hsgw/plaid/doc/case.md

# Soldering switches

Unplug USB cable and solder mx switches.   
You can choose grid or mit layout.
If finish soldering, you should test typing.

# Install bottom PCB and acrylic cover

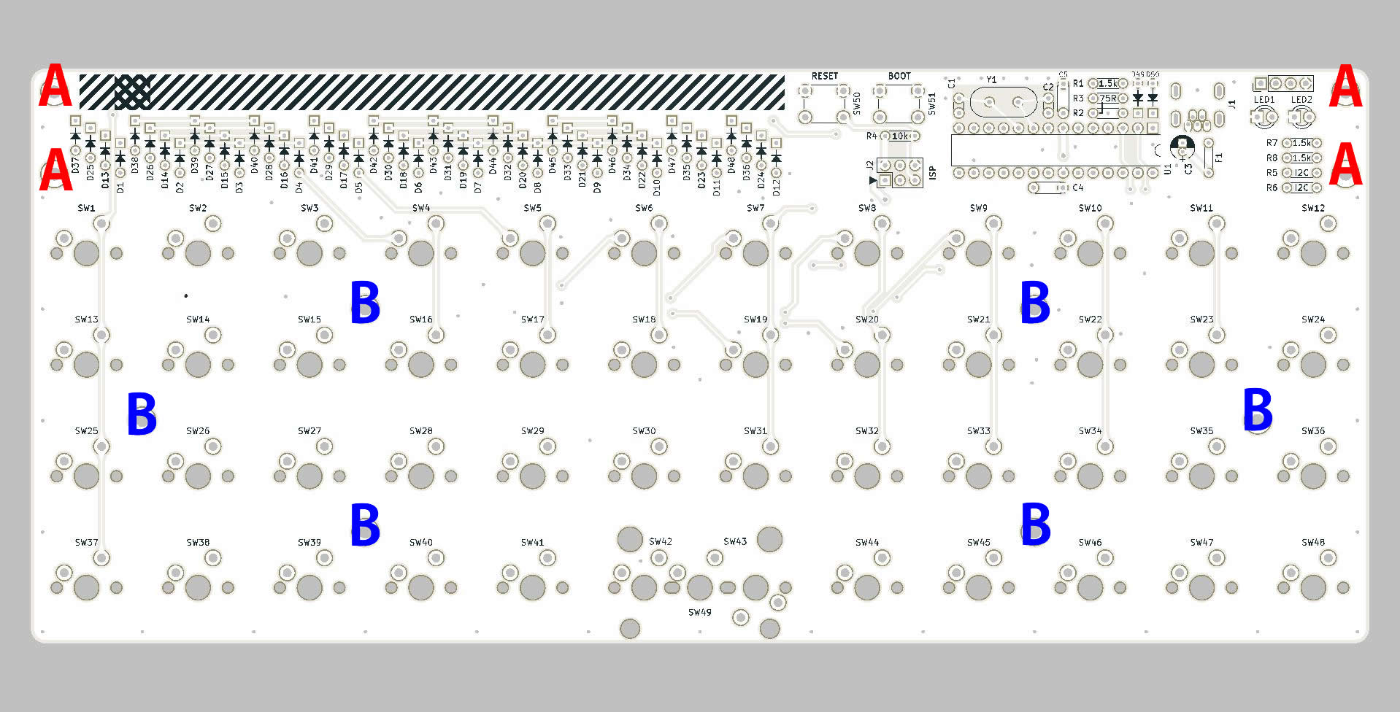
[picture p3: doc/img/assembly/plaid_pcb_top_screw.jpg]
hole


## A
use screws, nuts, spacers and acrylic cover.
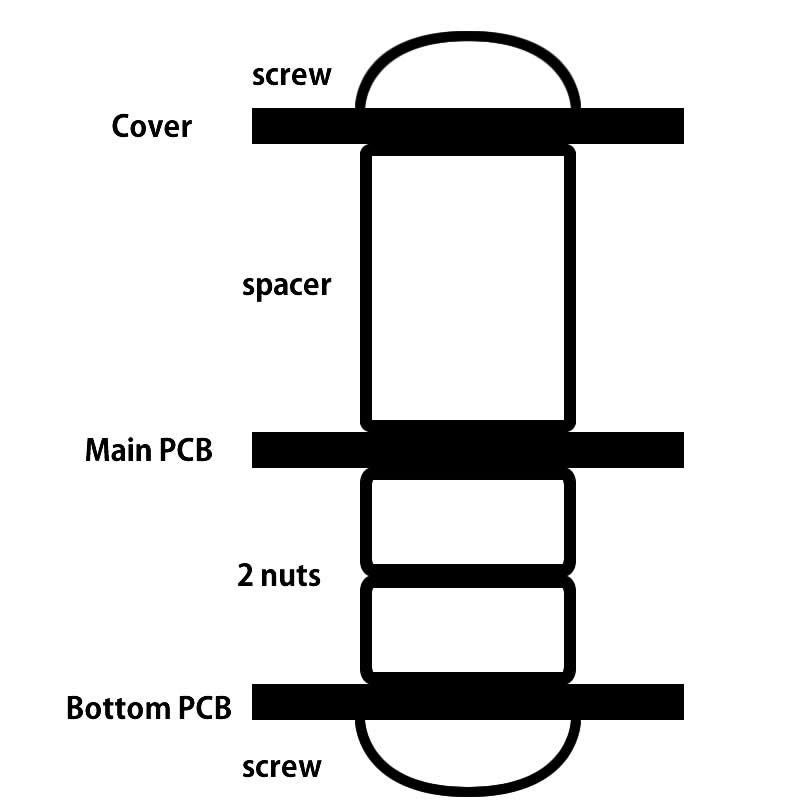
[picture p4: doc/img/assembly/screw_a.jpg]
screwA


## B
use screws and nuts.
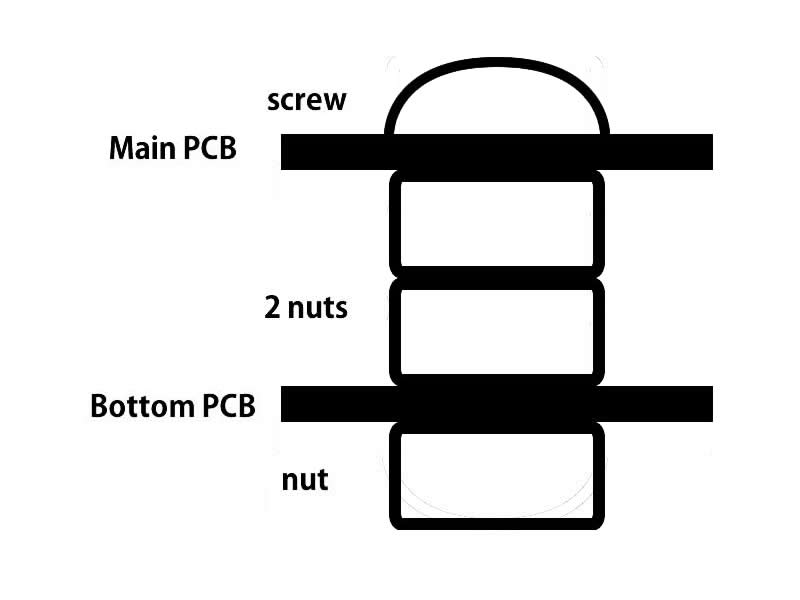
[picture p5: doc/img/assembly/screw_b.jpg]
screwB


## Install keycaps

## COMPLETE!
plaid
