hsgw/plaid/doc/jp/complete.md

# スイッチのはんだづけ

USBケーブルを抜いてスイッチをはんだづけします。
gridレイアウトとmitレイアウトが選べます。
はんだづけが終わったらPCに繋いで正しくタイピングが出来るか確認しましょう。

# ボトムPCBとアクリルカバーの取り付け

hole

## A
ねじ、ナット、スペーサー、アクリルカバーを取り付けます。
screwA

## B
ねじとナットを取り付けます
screwB

## キーキャップを取り付けます

## 完成!
plaid
