hsgw/plaid/doc/img/plaid_bottom_bottom.jpg

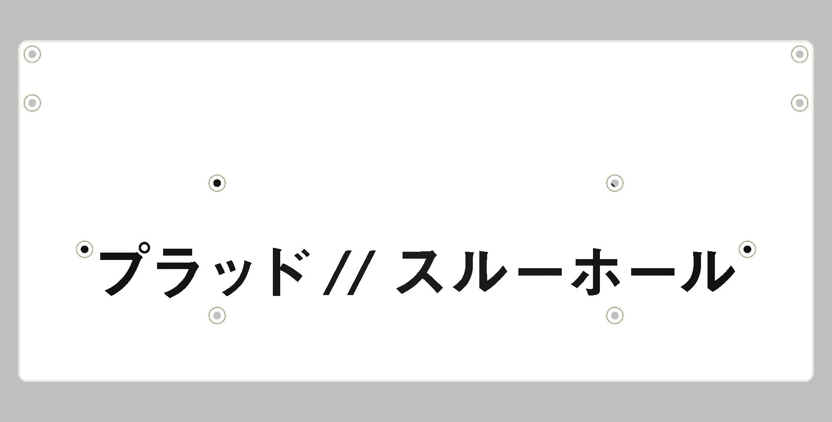
doc/img/plaid_bottom_bottom.jpg
