hsgw/plaid/doc/img/plaid_bottom_top.jpg

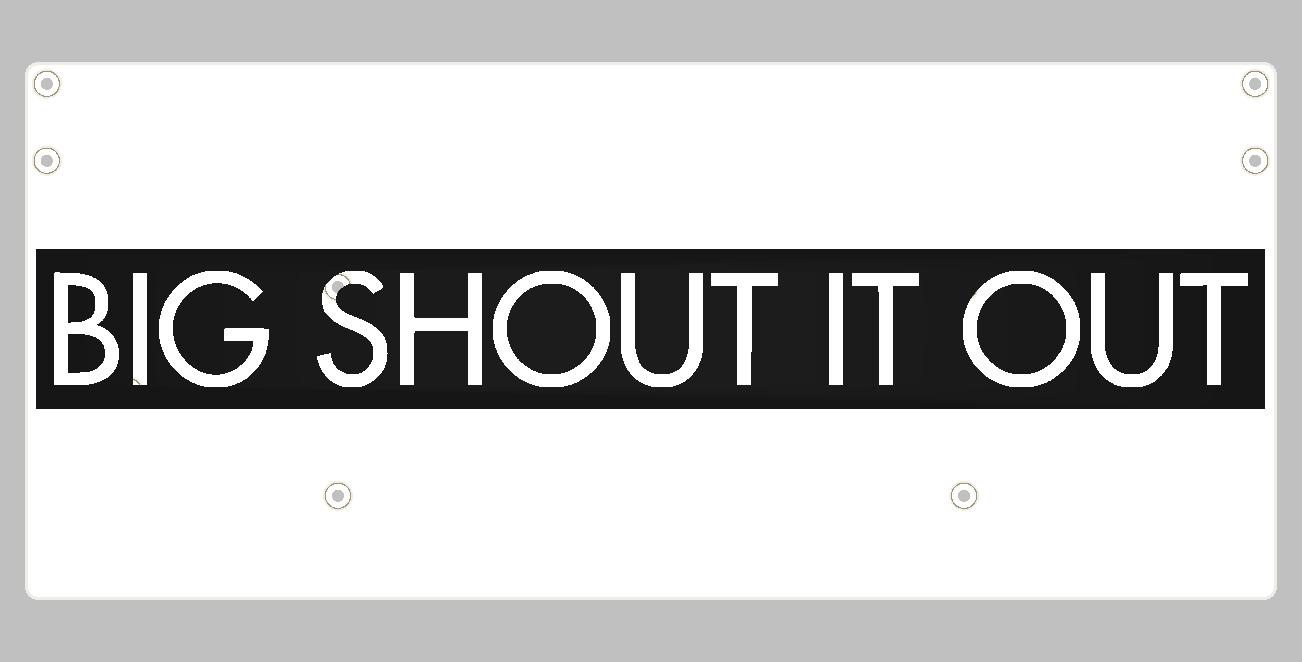
doc/img/plaid_bottom_top.jpg
