hsgw/plaid/doc/img/plaid_pcb_bottom.jpg

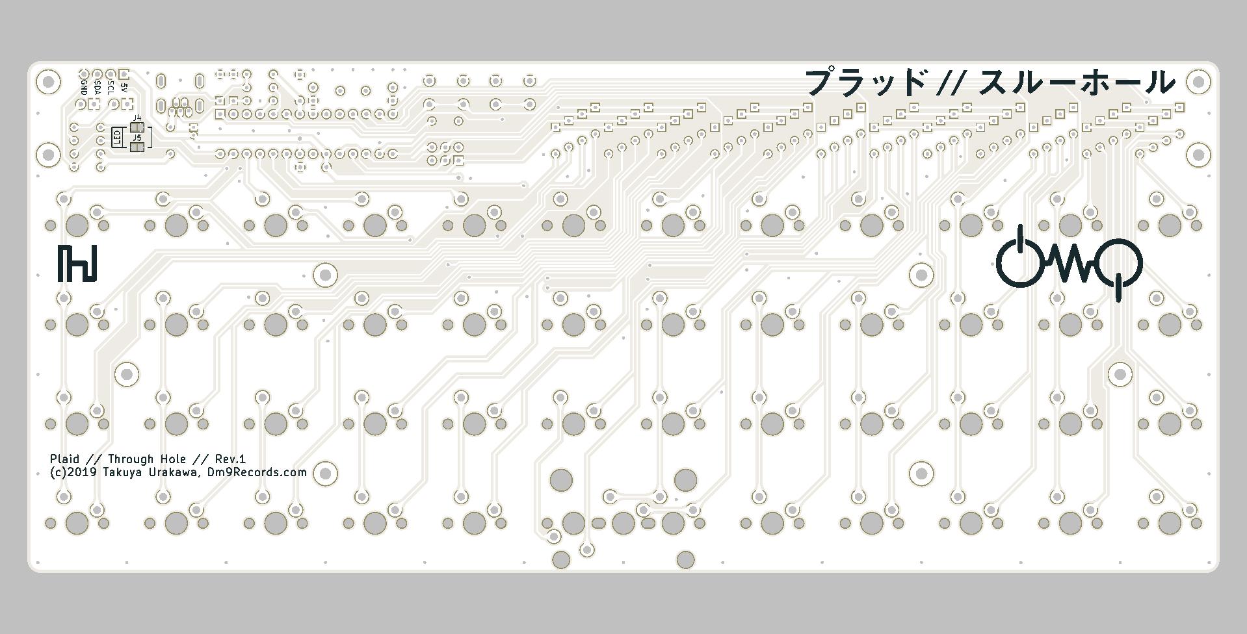
doc/img/plaid_pcb_bottom.jpg
