hsgw/plaid/doc/img/plaid_render_grid.png

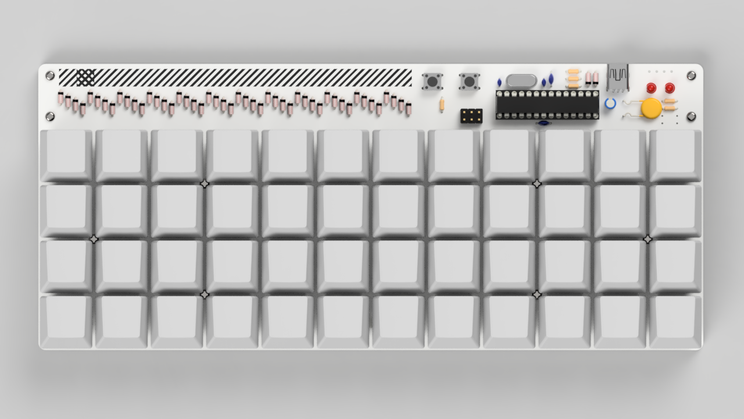
doc/img/plaid_render_grid.png
