hsgw/plaid/doc/en/BOM.md

# BOM 
## Included in Plaid kit
| | Ref | Qty | Value | Description |
|---|---|-----|---|---|
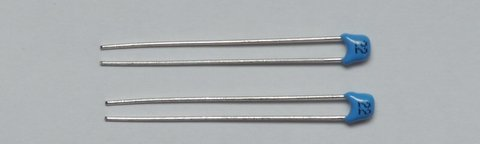
[picture p10: doc/img/parts/P1020154.JPG]
22pF
|  | C1, C2 | 2 | 22p | Multi layer ceramic capacitor (2.5mm pitch) |
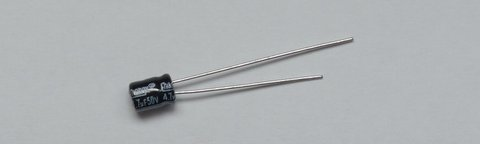
[picture p11: doc/img/parts/P1020157.JPG]
4.7uF
|  | C3 | 1 | 4.7u | Electrolytic capacitor (1.5mm pitch) |
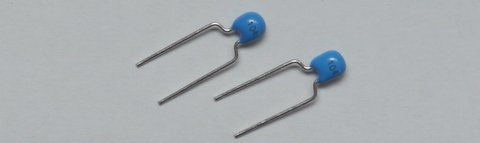
[picture p12: doc/img/parts/P1020155.JPG]
100nF
|  | C4, C5 | 2 | 100n | Multi layer ceramic capacitor (5mm pitch) |
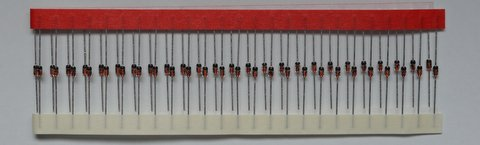
[picture p13: doc/img/parts/P1020138.JPG]
1N4148
|  | D1-48 | 48  | 1N4148 | General-purpose diode (DO-35) |
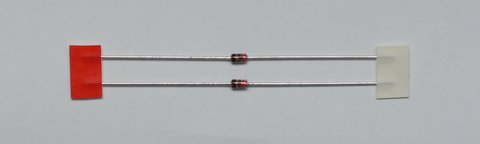
[picture p14: doc/img/parts/P1020151.JPG]
3.6V
|  | D49, D50 | 2 | 3.6V | 3.6V zener diode (DO-35) |
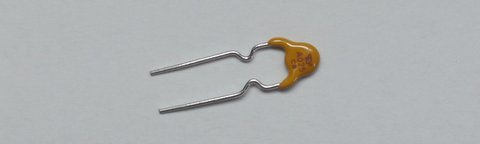
[picture p15: doc/img/parts/P1020156.JPG]
fuse
|  | F1 | 1 | 100mA | Resettable fuse (5mm pitch) |
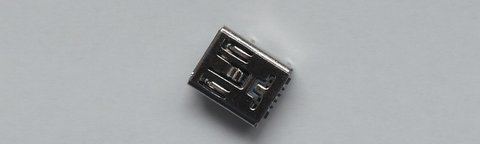
[picture p16: doc/img/parts/P1020147.JPG]
USB
|  | J1 | 1 | USB MINI-B | USB miniB connector |
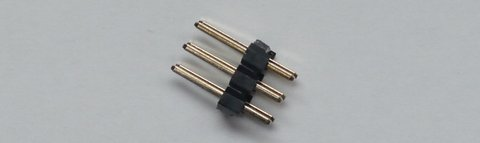
[picture p17: doc/img/parts/P1020158.JPG]
2x3
|  | J2 | 1 | 02x03 | AVR ISP pin header |
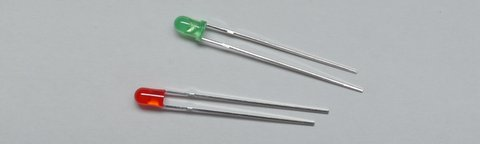
[picture p18: doc/img/parts/P1020159.JPG]
LED
|  | LED1,2 | 2 | RED, GREEN | 3mm LED |
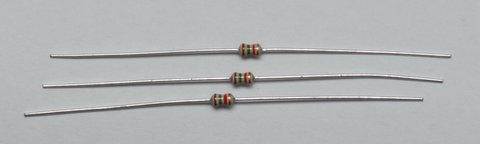
[picture p19: doc/img/parts/P1020161.JPG]
1.5k
|  | R1, R7, R8  | 3 | 1.5k | 1/6W resistor |
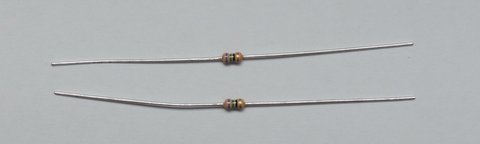
[picture p20: doc/img/parts/P1020160.JPG]
75R
|  | R2, R3 | 2 | 75R | 1/6W resistor |
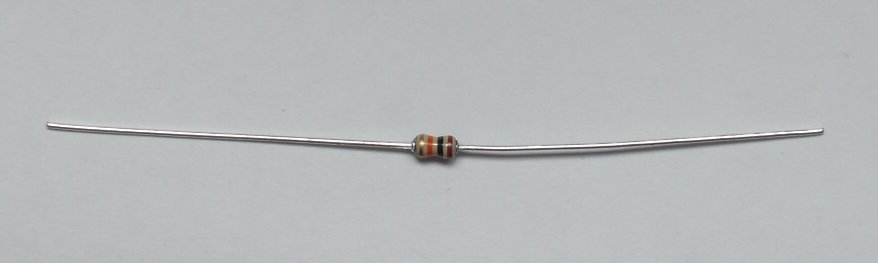
[picture p21: doc/img/parts/P1020162.JPG]
10k
|  | R4 | 1 | 10k | 1/6W resistor |
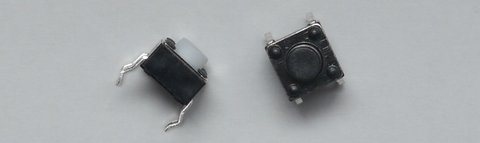
[picture p22: doc/img/parts/P1020153.JPG]
|  | SW50, SW51 | 2 | RESET, BOOT | 6mm tactile switch |
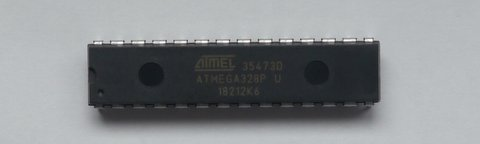
[picture p23: doc/img/parts/P1020149.JPG]
|  | U1 | 1 | ATMEGA328P | |
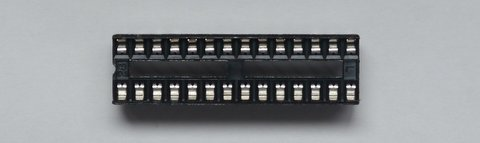
[picture p24: doc/img/parts/P1020148.JPG]
|  | IC Socket | 1 | 28pin | 28pin IC Socket |
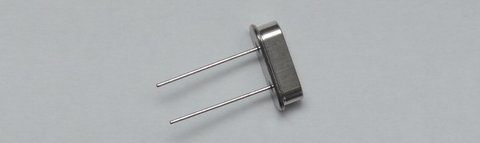
[picture p25: doc/img/parts/P1020150.JPG]
|  | Y1 | 1 | 16MHz | |
| | Screw | 14  | M2 8mm | |
| | Nut | 26  | M2 | |
| | Spacer | 4 | M2 10mm | |
| | Rubber Feet | 4 | | |
| | PCB | 1 | MAIN PCB | |
| | PCB | 1 | BOTTOM PCB | |

## Not included
- Cherry MX compatible switches * 48   
**PCB mount (5pin) type**

- USB miniB cable
