hsgw/plaid/(list of files, cad)

Other CAD files:
pcb/cover.dwg
