hsgw/plaid/doc/jp/soldering.md

# はんだづけ

## 組立を始める前に
- 部品が揃っているか[BOM](./BOM.md)を見て確認する
- もしはんだづけに不慣れなら以下のサイトで勉強する
  - [Helixキーボードキットの制作に必要な工具メモ](https://gist.github.com/mtei/6957107a676ddfa85bde0ae41f8fa849)内の[リンク集 - はんだづけ編](https://gist.github.com/mtei/6957107a676ddfa85bde0ae41f8fa849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)
  - https://learn.adafruit.com/adafruit-guide-excellent-soldering/tools

## はんだづけ
### ツェナーダイオード (D49,50)
D49とD50をはんだづけします。   
ダイオードは`極性`があります。向きに注意して下さい。   
ダイオードの黒い帯がある方がカソードです。(PCBの四角いパッド側)   

zener diode

### 抵抗 (R1,2,3,4,7,8)
抵抗をはんだづけします。   
R5とR6はI2C用なので何も実装しません。

| Ref | 値 | カラーコード |
|---|---|---|
| R1,7,8 | 1.5k  | 茶/緑/赤/金 |
| R2,3 | 75 | 紫/緑/黒/金 |
| R4 | 10k | 茶/黒/オレンジ/金 |
| R5,6 | I2C | 実装しない |

resistor

### ダイオード 1N4148 (D1-48)
ダイオードは`極性`があります。向きに注意して下さい。   
ダイオードの黒い帯がある方がカソードです。(PCBの四角いパッド側) 

1N4148

### クリスタル
crystal

### 積層セラミックコンデンサ (C1,2,4,5)
2種類のコンデンサがあります。

| Ref  | 値 | リードの間隔 |
|---|---|---|
| C1,2 | 22pF  | 2.5mm |
| C4,5 | 0.1uF | 5mm |

MLCC

### USB コネクタ
ピンの間隔が狭いのでブリッジに注意して下さい。   
はんだづけしたあとによく確認すること。

USB

### LED
LEDは`極性`があります。向きに注意して下さい。   
短い足の方がカソードです。(PCBの四角いパッドの方)

LED

LEDを使用するなら、PCB裏面のJ4とJ5をブリッジして下さい。

LED jumper

### ICソケット
ICソケットは`極性`があります。向きに注意して下さい。   
ICソケットの端の切り欠けとPCB上のシルクをあわせます。

ic socket

### 電解コンデンサ(C3)とリセッタブルフューズ(F1)
電解コンデンサは`極性`があります。向きに注意して下さい。   
短い足の方がカソードです。(PCBの四角いパッドの方)

リセッタブルフューズをはんだづけしたあと、画像のように折り曲げておきます。

Electrolytic capacitor and resettable fuse

### タクタイルスイッチ(SW50,51)とピンヘッダ

SW and pin header

### ATMEGA328P
ATMEGA328PをICソケットに差し込みます。

ATMEGA328Pは`極性`があります。向きに注意して下さい。   
ICソケットの切り欠けとATMEGA328Pの切り欠けをあわせます。   
画像も参考にして下さい。

ATMEGA328p

## USBケーブルを接続する前のチェックリスト
- VCC(5V)とGNDがショートしていないか、USBコネクタのピンがショートしていないか
- 極性のある部品の向き(ATMEGA328P、ダイオード、リセッタブルヒューズ、電解コンデンサ)
- 抵抗の値と場所

## NEXT
[USBケーブルを接続してブートローダをテストする](./bootloader.md)
