hsgw/plaid/doc/img/assembly/13.JPG

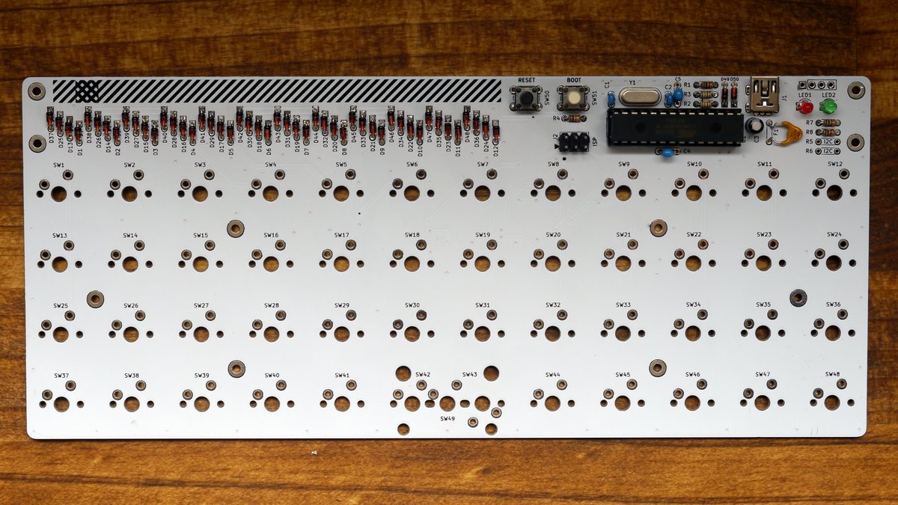
doc/img/assembly/13.JPG
