hsgw/plaid/(threads)

Thread 1 (2018-12-21):

PCB Rev.Alpha issues

hsgw, 2018-12-21:
- missing 2U stabilizer cutout
- R3 and R4 is 75 ohm (even 68 ohm, it should work)
- Polarized pads in C3 are other way around. but silk is correct.

hsgw, 2019-04-08:
Release Rev.1

Closed 2019-04-08.

Thread 2 (2019-02-14):

Resistor slots are too short for 10k and 1.5k resistors

themoonisacheese, 2019-02-14:
the slots for R1,4,6,7 are shorter than the standard size for these resistors.
I was able to mount them anyway by bending the leg under each resistor to match the hole, but please consider allocating more space, especially considering all of these resistors have (visually, I don't know if there is a trace there) enough space next to them.

hsgw, 2019-02-17:
All resistors are 1/8W and fit without issues.

Closed 2019-02-17.

Thread 5 (2019-04-10):

BOM Parts

mrceephax, 2019-04-10:
Hi,

I would be so helpful to have the parts organised either through octopart.com or with some serial numbers, I'm able to find them but its a bit difficult when the "Value" term is used as a generic  attribute.

Thanks

imbarelyonline, 2019-04-16:
I used Octopart to keep track of components as I found them on Mouser. You can use (and correct!) my list if you'd like. [Public Plaid Electronics](https://octopart.com/bom-tool/t5azwMqr/G5hAETgBxOPJR9aY)

miguelangelramirez, 2019-04-24:
Don't know if you guys have stumbled into this link to octopart with the list: https://octopart.com/bom-tool/t5azwMqr/G5hAETgBxOPJR9aY

lscott3, 2020-08-13:
So it looks like the two links shared here are the same.

Can someone verify that all of the parts listed work? If so, I think I'll open a PR to add the more detailed and exact name in the BOM list.

Thread 6 (2019-04-15):

make plaid:default:program fails with avr-gcc 8

brianmutualaid, 2019-04-15:
I just ran into this issue on macOS and thought I would open an issue just in case others have it too. When using the default avr-gcc (8.2.0) that's installed with homebrew, I get the following output when running `make plaid:default:program`:

```$ make plaid:default:program
QMK Firmware 0.6.308
WARNING:
 Some git sub-modules are out of date or modified, please consider running:
 make git-submodule
 You can ignore this warning if you are not compiling any ChibiOS keyboards,
 or if you have modified the ChibiOS libraries yourself.

Making plaid with keymap default and target program

avr-gcc (GCC) 8.2.0
Copyright (C) 2018 Free Software Foundation, Inc.
This is free software; see the source for copying conditions.  There is NO
warranty; not even for MERCHANTABILITY or FITNESS FOR A PARTICULAR PURPOSE.

Size before:
   text	   data	    bss	    dec	    hex	filename
      0	  14666	      0	  14666	   394a	.build/plaid_default.hex

Creating load file for EEPROM: .build/plaid_default.eep                                             [OK]
Copying plaid_default.hex to qmk_firmware folder                                                    [OK]
Checking file size of plaid_default.hex                                                             [OK]
 * The firmware size is fine - 14666/32768 (18102 bytes free)

avrdude: AVR device initialized and ready to accept instructions

Reading | ################################################## | 100% 0.00s

avrdude: Device signature = 0x1e950f (probably m328p)
avrdude: NOTE: "flash" memory has been specified, an erase cycle will be performed
         To disable this feature, specify the -D option.
avrdude: erasing chip
avrdude: reading input file ".build/plaid_default.hex"
avrdude: input file .build/plaid_default.hex auto detected as Intel Hex
avrdude: ERROR: address 0x8002a7 out of range at line 920 of .build/plaid_default.hex
avrdude: read from file '.build/plaid_default.hex' failed

avrdude: safemode: Fuses OK (E:FC, H:D0, L:D7)

avrdude done.  Thank you.

make[1]: *** [program] Error 1
make: Make finished with errors
*** [plaid:default:program] Error 1
```

I found a similar issue mentioned [on Reddit](https://www.reddit.com/r/MechanicalKeyboards/comments/apflr6/ergotravel_error_flashing_qmk_firmware_error/) and was able to work around it in the same way, by installing avr-gcc version 7.

Maybe this would be worth mentioning in the [Firmware](https://github.com/hsgw/plaid/blob/master/doc/en/firmware.md) section of the docs? I'd be happy to add a section for it and open a pull request, just let me know if that would be helpful.

hsgw, 2019-04-15:
Thank you for letting me know.

Please send PR!

brianmutualaid, 2019-04-15:
Opened a PR [here](https://github.com/hsgw/plaid/pull/7).

hsgw, 2019-04-16:
Thank you so much!

Closed 2019-04-16.

Thread 9 (2019-04-24):

Trying to open .chm file on Kicad, symbols display question marks

miguelangelramirez, 2019-04-24:
Symbols seem to be not displaying correctly, I'm using Kicad 5.1 BTW. Thanks for the files too!

nicholasterr24, 2019-05-02:
Hey, I am almost a complete beginner at keyboards, KiCad, and electronics, but I think this is a fix for most of the symbols. When you double click them on the schematic go to the Symbol library and type in whatever the symbol is supposed to be and find the correct library. For example, for the USB connector on the top left of the schematic, it says conn: USB_OTG, so i click on the browse library button and look up USB_OTG and it gives me the correct symbol. A lot of them also say "device: [something]" and you just have to change them to Device: [something] with a capital D instead of device: [something]. The only symbol I have not found so far is the ATMEGA328-PU or the GS2 symbols.

hsgw, 2019-05-07:
Hi,

As @nicholasterr24 says, please collect footprint library name.

I think that the cause of this is changing kicad footprint name.
So I should fix this soon.

Thanks.

hsgw, 2019-05-07:
I fixed this issue.
Can anyone try this schematic file?
https://github.com/hsgw/plaid/tree/kicad_sch

nicholasterr24, 2019-05-07:
Yeah, I just opened it and everything seems to look good, all of the symbols show up correctly

miguelangelramirez, 2019-05-07:
Hello all, @nicholasterr24 and @hsgw. Got around to fix it during the weekend using the same method double clicking the symbols. THANKS!

bjvanst, 2019-06-11:
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

That version of the project loads the symbols automatically for me in KiCad 5.1.2.

matthewwiese, 2019-12-26:
> I fixed this issue.
> Can anyone try this schematic file?
> https://github.com/hsgw/plaid/tree/kicad_sch

This also fixed my "??" missing symbol problem as well — I am using KiCad version 5.1.5

It seems like a fix to me. Should this be merged with master and the issue closed?

Thread 10 (2019-06-06):

Help with build

miguelangelramirez, 2019-06-06:
Hey guys, I managed to solder all the components into the PCB including switches. Currently trying to burn the bootloader from my mac but have had no luck just yet.

Should LEDs turn on once connected?

I've used the direction in the bootloader.md file and also in the _alpha file with no luck :(

hsgw, 2019-06-06:
Hi,

LED is not turn on when connected.

Could you check soldering and the directions of component again?

miguelangelramirez, 2019-06-06:
Double checked the soldering, thought I saw a bridge on the capacitor but there was no bridge at all
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

BenRoe, 2019-06-06:
Are you using the ISP header? Which device you use to burn the bootloader on the chip?
Check also https://github.com/baerwolf/USBaspLoader/issues/19

miguelangelramirez, 2019-06-06:
I'm plugging the keyboard to my computer through USB, should I use the ISP header to burn the bootloader??

BenRoe, 2019-06-06:
Do you bought the kit via the original [GB](https://www.reddit.com/r/mechmarket/comments/apf0ng/gb_plaid_throughhole_kit_12x4_ortholinear/) or [keycapsss.com](https://keycapsss.com)?
If yes, the bootloader is already burned and you only have to follow the[ firmware steps.](https://github.com/hsgw/plaid/blob/master/doc/en/firmware.md)

miguelangelramirez, 2019-06-06:
I ordered my PCB from jlcpcb since I couldn't get a kit, I know I suck.

LorenzoMarsicano, 2019-06-06:
I've bought the kit from the GB, but even after another check to both soldering and schematics my pc (both windows and Linux) won't notice that a new device has been connected to it.

Could it be that the atmega is not working properly?
How do I check that?

BenRoe, 2019-06-06:
Ok, i can give you some tips, but can't explain the whole process.
You need a ISP Flasher like the usbtinyisp (cheap on ebay or aliexpress).
Connect the usbtinyisp via usb to the pc.
Connect usbtinyisp to plaid via isp header.
Use avrdudess (gui for avrdude) on windows. It's easier.

Use yellow marked settings, but replace it for the following settings.
L (LFUSE): 0xF7
H (HFUSE): 0xD0
E (EFUSE): 0x04
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

LorenzoMarsicano, 2019-06-06:
Wow, thank you very much, this was way more than I expected from you!

I'll try this as soon as possible, thanks!

miguelangelramirez, 2019-06-06:
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

That is awesome!! sadly they take some time to delivery and I'm moving to LA soon :(. I'll order one when I get my new address, but still try to load it with my Arduino Uno/breadboard...I think I have all the parts just laying round.

Thanks bro!

LorenzoMarsicano, 2019-08-07:
I've tried flashing the bootloader with the USBTiny programmer with no luck at all.

The most weird thing is that avrdude is successful in writing the bootloader even if the board isn't officially in DFU mode (success either after or before pressing the buttons).

itsnoteasy, 2020-02-09:
here's how I got it to work.
1, open plaid_default.hex in text editor, remove last line :00000001FF
2, append usbasp bootloader on to end
3, flash using teensy 2.0 with qmk isp flashing guide
avrdude -c avrisp -p m328p -P /dev/ttyACM0 -b19200 -U flash:w:donegal_default.hex
avrdude -c usbasp -b19200 -p m328p
one fuse didn't write but it wasn't important.
then make plaid:default:program to program normally over usb.
the issue seems to be that an incorrect baud rate was used.

BenRoe, 2020-02-09:
If you use a newer qmk firmware, then use `make plaid:default:flash` and not `plaid:default:program`.

itsnoteasy, 2020-05-28:
I was having difficulty entering the bootloader and i'd like to note the docs are wrong. the correct procedure is:
Enter bootloader mode

    Push and hold BOOT SW
    Plug into USB cable
    Release BOOT SW
    make plaid:flash
    Push and release RESET SW

denisinvader, 2020-08-28:
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

This worked for my kit ordered from mechboard (preflashed I guess)

Daveyr, 2021-01-06:
@itsnoteasy, would you mind elaborating? Are you using the `main.hex` file from the plaid fork of the USBaspLoader repository? In step 2, which file contents do you append to the bottom of it? I'm trying to use avrdudess in Linux (using mono), with an Arduino nano as a programmer but not having any success. My settings are below but I think the main issue is the hex file.
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

itsnoteasy, 2021-01-06:
that's correct, step 2 is copy paste the ascii from this file https://github.com/hsgw/USBaspLoader/blob/plaid/firmware/main.hex
I don't know what the error is with your setup but it could be using the nano for programming isp. a teensy 2.0 would have a lower learning curve.

Daveyr, 2021-01-09:
Thanks for the clarification. So I combine the main.hex from [here](https://github.com/hsgw/USBaspLoader/blob/plaid/firmware/main.hex) with the main.hex from your file above into one file (removing the last line from the first file - contains `:00000001FF`)?
I've named this plaid_bootloader.hex and managed to upload it using an arduino nano using the following command:

```
avrdude -u -c arduino -p m328p -P /dev/ttyUSB0 -b 115200 -U flash:w:"/home/ubuntu/Documents/projects/keyboards/plaid/bootloader/plaid_bootloader.hex":a -U lfuse:w:0xF7:m -U hfuse:w:0xD0:m -U efuse:w:0x04:m
```
However, it complains about the efuse setting.

avrdude: 1 bytes of efuse written
avrdude: verifying efuse memory against 0x04:
avrdude: load data efuse data from input file 0x04:
avrdude: input file 0x04 contains 1 bytes
avrdude: reading on-chip efuse data:

Reading | ################################################## | 100% 0.01s

avrdude: verifying ...
avrdude: verification error, first mismatch at byte 0x0000
         0xfc != 0x04
avrdude: verification error; content mismatch

avrdude done.  Thank you.

Incidentally, this is exactly the same error I find when I burn the bootloader using Arduino software. I created a new board definition with the fuse settings you showed above and the error message was almost identical.

When I run `avrdude -c usbasp -p m328p` it says that no such device is connected. Any ideas?

Daveyr, 2021-02-01:
After much trial and error I think I've worked it out. I wrote a blog post [here](https://www.algorist.co.uk/post/how-to-burn-the-plaid-keyboard-bootloader-using-arduino-nano/) but the summary is below.

First upload the standard avrisp example sketch to the Arduino Nano. Note, the default baud rate is 19200.
Using the method described [above](https://github.com/hsgw/plaid/issues/10#issuecomment-583849113) to make the hex file, I entered the following in a terminal on a pc connected to the Arduino, in turn connected to the ISP headers on the keyboard.

```
avrdude -u -c avrisp -p m328p -P /dev/ttyUSB0 -b 19200 -U flash:w:"plaid_default.hex":a -U lfuse:w:0xF7:m -U hfuse:w:0xD0:m -U efuse:w:0xfc:m
```
Notes.
1. When burning the bootloader you need a 10nF capacitor across GND and RST pins on the Arduino Nano (no need for other Arduino types)
2. The programmer is actually `avrisp` rather than arduino
3. The efuse setting in the plaid firmware repo is wrong; it should be 0xfc
4. I had to disconnect the Arduino from the keyboard in order for it to be properly detected

MrCrazyUkrainian, 2021-05-27:
Hi all!
I am having the same problem as originally described in this thread: I soldered everything seemingly correctly and yet the keyboard isn't detected by my WIndows PC in the device manager. It just lists it as an unrecognized USB device. I followed the guide and installed the libusBK driver and was using button press combinations from the OG guide and what was reccomended by @denisinvader , and yet it stil isn't recognized. Does anyone of you have any ideas what I should do?
I bought the kit from mechboards.co.uk and it is supposed to have firmware preflashed onto the ATmega ship.

chief-teep, 2021-06-04:
Was the board in bootloader mode when you installed libusbk in zadig? It should show up as usbasb for the device if done correctly.

I made the mistake of installing libusbk as the device driver instead of the bootloader and had the same issue as you did.

MrCrazyUkrainian, 2021-06-04:
Update on my troubles. They are now resolved.
Solder USB connector carefully and check multiple times that all the pins have continuity to the corresponding components, as in my case one of the data lines wasn’t soldered properly (solder pad split) and that was the cause of everything.
After plonking a bit of solder onto that problematic joint everything works fine.
Admittedly it took me and MechBoards UK support staff way too much time to figure out.

chief-teep, 2021-06-04:
Glad you got it sorted! Don't feel too bad about it taking so long to figure out, I flashed a keymap to my plaid using the newest qmk version and it was bricked for 2 months before I figured out that I needed to use an older release -_-

Ardakilic, 2022-04-28:
Late to the party. I could not program the chip with USB ISP programmer, and I ended up using a Raspberry Pi instead. The All of my programmers, although they showed uploaded successfully (tried on macOS), did not apparently upload the bootloader to my cheap atmega328p.

The issue for me was both for Plaid and Lumberjack, which apparently is quite similar in terms of technicality.

Thread 11 (2019-07-16):

Cannot enter bootloader mode

nguyenhimself, 2019-07-16:
I had my Plaid working for a month. Now I want to flash a new layout.
I understand that to enter bootloader mode, I have to:

1. Plug into USB cable
2. Push and hold RESET SW
3. Push and hold BOOT SW
4. Release RESET SW
5. Release BOOT SW

However, when I pushed the BOOT button, it just output "edc", i.e the keys on the 4th column, so now I cannot enter bootloader mode to flash my new layout.
Again, aside from the BOOT button, all the other keys of my Plaid still works fine.
How should I go about solving this? Thanks.

Snowdrifft, 2019-07-16:
check if your RESET button works, it will disconnect and reconnect the board.
Will return "edc" if switch button is not pushed down while pressing the BOOT button

miguelangelramirez, 2019-07-16:
Cool, just ordered a new atmega chip with a pre-loaded bootloader on it. Will check on this method when I finally get it. Thanks!

> check if your RESET button works, it will disconnect and reconnect the board.
> Will return "edc" if switch button is not pushed down while pressing the BOOT button as BOOT switch is using the same pin as COL3 (See schematics).

Closed 2019-08-02.

Thread 12 (2019-07-18):

Support for a rotary encoder

To1ne, 2019-07-18:
I'm curious what it would take to add a rotary encoder to the Plaid?

Some related links:
- https://www.reddit.com/r/MechanicalKeyboards/comments/brnl0q/a_companion_for_my_planck/
- https://www.reddit.com/r/olkb/comments/9jzbg1/help_with_rotary_encoder_code/

hsgw, 2019-08-02:
Hi, I wouldn't like to add support rotary encoder on pcb.
But you can use i2c pins.

Closed 2019-08-02.

Thread 14 (2019-08-09):

Led series resistor value

BenRoe, 2019-08-09:
Hi,
a 1.5k series resistor (R7, R8) for the led's seems a bit high. My led glow so low, that it's not visible during the date.
Is a value 470Ω, or even less not better?
How much is the signal from the Atmega328P 3V or 5V?
If i [calculate](https://www.hobby-hour.com/electronics/ledcalc.php) the series resistor for a red led, it suggest's a 150Ω resistor.

hsgw, 2019-08-26:
Atmega328p run at 5V.

I think my leds is bright enough.

If they are changed to 470R or 150R, LEDs are brighter and shouldn't be broken.

BenRoe, 2019-08-28:
First i bought led's with 60-100mcd and they were so low that you can't see them at daylight.
Then i bought some with 600-800mcd and they have a good glow.
Maybe it's worth to mention in the BOM.

Closed 2020-01-06.

Thread 15 (2019-08-24):

Wrong keys being sent.

ekosynth, 2019-08-24:
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

After building the Plaid all the keypresses were registering correctly, except one dead key. I was trying to trace this but since then only some of the keypresses work, and they dont match the keys that I'm pressing. A lot of the keys seem to trigger some combination with ctrl and alt too.

I've tried reflashing the firmware, but nothing seems to affect it. Any idea what I've done wrong?

hsgw, 2019-08-26:
Please check switch matrix isn't short.
And test this keymap below.
```
[0] = LAYOUT_plaid_grid(
    KC_A,     KC_NO, KC_NO, KC_NO, KC_NO, KC_NO, KC_NO, KC_NO, KC_NO, KC_NO, KC_NO, KC_NO,
    KC_NO,  KC_NO, KC_NO, KC_NO, KC_NO, KC_NO, KC_NO, KC_NO, KC_NO, KC_NO, KC_NO, KC_NO,
    KC_NO,  KC_NO, KC_NO, KC_NO, KC_NO, KC_NO, KC_NO, KC_NO, KC_NO, KC_NO, KC_NO, KC_NO,
    KC_NO,  KC_NO, KC_NO, KC_NO, KC_NO, KC_NO, KC_NO, KC_NO, KC_NO, KC_NO, KC_NO, KC_NO
),
```

ekosynth, 2019-08-26:
@hsgw I tried the keymap you sent and this is what I get pressing all the different keys:
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

I can't seem to find a short in the matrix. I wonder if maybe I've damaged the atmega328?

Bauncer, 2019-09-24:
I’ve just had the exactly same problem with my plaid yesterday. Rebooted my PC and keypresses were messed up. Found this in r/olkb: https://www.reddit.com/r/olkb/comments/d35aqo/help_with_plaid_thk_sending_seemingly_random/

Will try the fix later

gipsy-king, 2020-08-14:
confirming that
```void matrix_init_user(void) {
  eeconfig_init();
}```
also fixed the issue for me.

elasticrash, 2020-09-12:
I am not quite certain if its related. I had a similar issue. Only when I press the key where the spaces are, it then switched to layer 3. I flashed an option on layer 3 to go back to layer 1 and that works. But I have to do it every time I plug it in. I will try the matrix init and see if that makes a difference

Thread 18 (2020-04-14):

PCB fab?

georges, 2020-04-14:
Anyone has recommendation on best place to get PCB made? Any particular gotcha to look for? Is the bottom PCB required or just for mechanical purpose?

miguelangelramirez, 2020-04-14:
I got mine from jlcpcb, believe that the bottom layer is just to cut cost and avoid the need for a case.

Would love to hear what people did if they ordered their own PCB from a third party.

Tenkir, 2020-06-30:
Ordered from JLCPCB, super simple. The bottom layer is indeed just a mechanical backplate, no traces.

Thread 20 (2020-06-23):

Unclear documentation

CrisHale, 2020-06-23:
In the file https://github.com/hsgw/plaid/blob/master/doc/en/bootloader.md it says "If you buy kit, already burn bootloader in ATMEGA328p" but it's not clear what this means, or what you should do if you bought a kit. Also, I'm unsure how much of this applies to the Plaid Gold, which is what I have. Some if the documentation doesn't apply, I know, but it's not clear which does and doesn't.

There's also the line "When you burn bootloader to raw ATMEGA328p, don't forget write fuse bits." but it doesn't explain what's involved in writing the fuse bits, or how you can find out.

The section for what to do with Windows is also a bit simple. It doesn't give you any clues on how to use Zadig. The software suggests the USB item should be plugged in and chosen from a list, but in the Plaid documentation you're not asked to plug in the USB cable until the next step (Enter bootloader mode).

BenRoe, 2020-06-28:
@CrisHale the plaid and plaid gold bootloader and firmware are identical.
Here you can find more information about how to flash the bootloader with avrdudess https://github.com/baerwolf/USBaspLoader/issues/19

CrisHale, 2020-06-29:
@BenRoe Thanks, I will try restoring the correct bootloader on the chip I have.

BenRoe, 2020-06-29:
@CrisHale do you changed the bootloader, or bricked the mcu?
The Plaid Gold kit comes with a pre flashed bootloader and firmware. So everything should work right after correct soldering.

CrisHale, 2020-06-29:
@BenRoe I don't know if you remember me, but I'm the guy who soldered the USB connector on upside-down. I flashed a new bootloader before I realised that was the real problem. I assume the chip still works, but I can't test it until the replacement kit you've sent gets here and I solder it up (properly this time).
I was just thinking that if I ever do manage to fix the soldering, I could try the PCB I have again to see if it works.

BenRoe, 2020-06-29:
@CrisHale yes i remember. Hope the replacement arrives soon.

@hsgw you can close this issue

Closed 2020-06-29.

Thread 21 (2020-06-23):

USB device is unrecognised

CrisHale, 2020-06-23:
Is this what you get when a bootloader needs to be installed?
Are there any specific instructions on how to install the bootloader or do you follow the Readme on [this](https://github.com/hsgw/USBaspLoader/tree/plaid) page?
Is everything already set up that needs setting up?
Does it work the same way with the Plaid Gold?

Thanks,
Cris

Edit: To be clear, I have the Plaid Gold all soldered and I also happen to have an Arduino Mega 2560 board which it seems I could use to install a bootloader. I'm really out of my depth here, so any help would be appreciated.

Edit 2: I'm going to leave this up in case I asked any valid questions (I'll let someone else decide that), but I realised I soldered the USB-C connector on the wrong side of the board. I don't know why it didn't occur to me that you could do that, but it didn't.

Closed 2020-07-02.

Thread 22 (2020-06-30):

Update Files for USB-C Support

Tenkir, 2020-06-30:
Currently the PCB is laid out for micro-USB.

hsgw, 2020-07-03:
Ah, I think USB-C through hole connector is little unusual. So I would like to keep it mini-B.

Tenkir, 2020-07-09:
I've seen these available, have never tried them though.
https://www.newark.com/edac/690-024-632-031/usb-connector-3-1-type-c-rcpt/dp/98Y3918

Tenkir, 2020-07-18:
Just found this kit which uses a through-hole USB-C connector:
https://keycapsss.com/diy-kits/104/plaid-pad-4x4-macro-pad/numpad

piit79, 2020-08-08:
Both Discipline (65%) and Mysterium (TKL) through-hole boards use a through-hole USB-C connector: https://www.digikey.com/product-detail/en/USB4085-GF-A/2073-USB4085-GF-ACT-ND/9859733 I'll take a stab at modifying the PCB for this connector.

piit79, 2020-08-11:
So, looks like I managed to do it, see the pull request above. I included the zip file with the gerbers if anybody wants to inspect them. This was my first go at KiCad, so I hope I haven't messed anything up. Guess I'll have to order some prototypes and see for myself :)

bhuhnke, 2020-08-12:
I'd love to see this implemented! Maybe as a separate USB-C version?

piit79, 2020-08-12:
@bhuhnke Yes, I was also thinking a separate branch would be warranted because of the limited availability of the through-hole USB-C connector (I only found it at DigiKey...).

Either a new branch for the USB-C version, or make the USB-C default and create a new branch for the current Mini USB version.

bhuhnke, 2020-08-12:
> @bhuhnke Yes, I was also thinking a separate branch would be warranted because of the limited availability of the through-hole USB-C connector (I only found it at DigiKey...).

I‘ve got a spare one around from a self ordered discipline built and I‘d love to try it on the new pcb! Uploaded the gerber file to jlcpcb just for kicks and they didn‘t spit out any errors. I don‘t know if they check anything with the files while uploading though.

piit79, 2020-08-12:
@bhuhnke I don't suppose you're in the EU? I'm probably going to order the minimum quantity which is 5 from JLCPCB, could easily send you one for testing.

bhuhnke, 2020-08-12:
@piit79 I‘m from germany :) That would be awesome!

Thread 23 (2020-07-02):

What are resistors R5 and R6?

CrisHale, 2020-07-02:
There's nothing in the guide that explains what these are for, and they don't seem to be included in normal use. What is their purpose?

hsgw, 2020-07-03:
R5 and R6 are for i2c pullup resistors.

Closed 2020-07-04.

Thread 24 (2020-07-02):

Do I need libusbK?

CrisHale, 2020-07-02:
I've plugged the board in and it's recognised as USBasp by Zadig while the Device Manager shows it under 'libusb-win32 devices' as 'USBaspLoader'. Is that enough, or do I still need libusbK?
What does libusbK do here?

CrisHale, 2020-07-02:
Seems you don't need it, as far as I can tell. Perhaps it was necessary in Windows 7 or something.

Closed 2020-07-02.

Thread 25 (2020-07-02):

Should I have nuts?

CrisHale, 2020-07-02:
But seriously, I have the Plaid Gold kit and I've got two differently sized spacers, 5 mm and 8 mm, but the guide says you should have nuts that connect the back plate. Does that mean I'm missing something? I only have 10 5 mm spacers, which is not enough to secure all the screws.

BenRoe, 2020-07-02:
@CrisHale please asked plaid gold related questions at the keycapsss discord server or via mail.

CrisHale, 2020-07-02:
@BenRoe I think I've figured it out - the small screws could go on the bottom, but thanks.

Closed 2020-07-02.

Thread 26 (2020-07-02):

What are the diameters for the screws?

CrisHale, 2020-07-02:
I have a screw with a bad thread (one of the long ones). I can make do with three for now, but I'll see how much to replace it if I can find out the diameter, or specification generally, for it. Thanks.

hsgw, 2020-07-03:
Hi, Are you talking about the spacer for acrylic plate?
If so, they are 8mm.

CrisHale, 2020-07-04:
Hi, the screw itself. The 8 mm ones, yeah. I need the diameter as well, and possibly other information. Or a link to where they come from would do nicely, if you've got a source. Thanks.

piit79, 2020-08-13:
@CrisHale The screws are M2 (see [BOM](https://github.com/hsgw/plaid/blob/master/doc/en/BOM.md)), so the diameter is a bit less than 2 mm (see [ISO metric screw thread](https://en.wikipedia.org/wiki/ISO_metric_screw_thread) on Wikipedia).

Thread 30 (2020-09-18):

Connect OLED?

denisinvader, 2020-09-18:
I saw [this post](https://www.picuki.com/media/2229336102125338862) but couldn't find any info.

I would like to connect OLED screen (SSD1306) and have some questions:
1. Should I solder I2C resistors?
    - If I should, which value?
1. Will LEDs works the same way with OLED screen connected and controlled?

frstff, 2021-02-19:
Hi there!
If You're still interested, here are the answers:

1. No, all you need is to wire 4 I2C pins to corresponding holes on the board.
2. You'll have to desolder LED bridges on PCB to use I2C, therefore you won't be able to use them.
I think true to the spirit of the board solution would be to redesign the PCB for I2C ports to match those on standard OLED screen and connect it directly.

Ardakilic, 2021-07-16:
Hello,

Any how-tos or guides available to make this mod?

Thanks,

frstff, 2021-07-16:
Hi!
I've just bought 4-pin connector for LED strips, cut it in half, checked which pin corresponds to which wire with multimeter, soldered it according to pins on OLED screen, and plugged the screen in.

Ardakilic, 2021-07-18:
Hey @frstff , thanks for the reply!

> checked which pin corresponds to which wire with multimeter,

My Plaid is still on the say (being printed). If the pins are shown with silkscreen, it'd be easy. VCC and GND identification should not be a problem. When PCBs arrive and I still can't manage I'll let you know. Thanks!

Thread 31 (2020-10-01):

Need help

4dvn, 2020-10-01:
Can i program it to midi controller with mattix 16 buttons? How can i upload midi code to this board?

Daveyr, 2021-01-14:
Apparently midi is still a work in progress for the qmk firmware but you can find information [here](https://docs.qmk.fm/#/feature_audio?id=midi-functionality).

Thread 33 (2020-11-19):

Verification error when flashing bootloader.

Tenkir, 2020-11-19:
When attempting to flash `main.hex` from the [bootloader ](https://github.com/hsgw/USBaspLoader/blob/plaid/firmware/main.hex) repository, avrdude throws the following error:

```
$avrdude -u -c usbtiny -p m328p -P usb -b 115200 -V -e -U flash:v:"C:\Users\tenkir\Downloads\USBaspLoader-plaid\USBaspLoader-plaid\firmware\main.hex":a

avrdude.exe: AVR device initialized and ready to accept instructions

Reading | ################################################## | 100% 0.01s

avrdude.exe: Device signature = 0x1e950f (probably m328p)
avrdude.exe: erasing chip
avrdude.exe: verifying flash memory against C:\Users\tenkir\Downloads\USBaspLoader-plaid\USBaspLoader-plaid\firmware\main.hex:
avrdude.exe: load data flash data from input file C:\Users\tenkir\Downloads\USBaspLoader-plaid\USBaspLoader-plaid\firmware\main.hex:
avrdude.exe: input file C:\Users\tenkir\Downloads\USBaspLoader-plaid\USBaspLoader-plaid\firmware\main.hex auto detected as Intel Hex
avrdude.exe: input file C:\Users\tenkir\Downloads\USBaspLoader-plaid\USBaspLoader-plaid\firmware\main.hex contains 30868 bytes
avrdude.exe: reading on-chip flash data:

Reading | ################################################## | 100% -0.00s

avrdude.exe: verifying ...
avrdude.exe: verification error, first mismatch at byte 0x7000
             0xff != 0x6b
avrdude.exe: verification error; content mismatch

avrdude.exe done.  Thank you.
```

4dvn, 2020-11-19:
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

you need to set fuses and upload bootloader via avrdudess and use usbasp to upload

Tenkir, 2020-11-19:
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

This is while attempting to install the bootloader via avrdude and usbtiny.

I am running these commands in debian:
```
make firmware
make flash
```

4dvn, 2020-11-19:
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

you can try usnoobie bootloader with your crystall: http://eleccelerator.com/usnoobie/downloads.php

Tenkir, 2020-12-02:
I was able to successfully flash the bootloader and the fuses. However, now when I plug the keyboard into my machine, it freezes all USB devices until unplugged.

Ardakilic, 2021-08-09:
I don't know if this would help but Googling brought me here several times when I have struggled.

I have bought ATMega328p from China, and wanted to flash the bootloader. Windows didn't help me at all with latest updates installed. macOS (and possibly all Linux variants would have) worked nicely instead.

I have installed the bootloader hex file successfully today with a Chinese generic USB ISP programmer, and within the help of avrdudess.

I wired like this:

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

I stole the commands from AVRDUDESS:

```bash
avrdude -c usbasp -p m328p -B 0.5 -V -U flash:w:"C:\full\path\main.hex":a -F
```
Then flashed like this in macOS:

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

I had no errors, and people say the warning is due to my ISP programmer being a Cheap Chinese one. (100nf capacitor on VCC line didn't help neither). I have not yet tried, but I believe this way it should work. It took a couple of seconds to upload.

I have downloaded the file like clicking to it, then clicking "view raw" , then saving as `file.hex`

Thread 34 (2020-11-23):

Micro USB female connector type

Daveyr, 2020-11-23:
Which variant is the micro USB socket? The footprint looks like a through-hole connector but I cannot find anything online that matches the 5 pin, through-hole, 2 rows configuration on the board.

Daveyr, 2020-11-24:
On second read it is a mini USB socket.

Closed 2020-11-24.

Thread 35 (2021-07-26):

USB Device Unknown Descriptor after build

rwcts, 2021-07-26:
I have double and triple checked the soldering and looked at it under the scope but all looks good. After getting it all done I connected it via USB and I heard the Windows USB detection sound. That is when it showed that the device connected is having issues and gave an unknown descriptor message in device manager. Suggestions on what to do next?

jbeanland, 2021-07-28:
@rwcts any luck with this? I have the same thing but can only find old dead threads describing the problem, not any with a solution..

rwcts, 2021-07-28:
no luck as of yet. Since I have quadruple checked all solder joints I'm not sure. I'm thinking something may be soldered in wrong but all polarized components look to be correct according to the assembly instructions. There were some discrepancies in the assembly as the board I have is black and the picture is white. One of the assembly instructions i found show the chip to be installed one way but im following the board graphics to place the chip in correctly. I tried a different cable as that can definitely cause this type of issue too but I have used 4 cables with the same issue. Tried a different computer and port as that can cause it too. Otherwise no luck at this point.

hsgw, 2021-07-29:
Hi,
VUSB may have a compatibility problem with your computer's USB Host IC.
Can you try it on another computer?

jbeanland, 2021-07-29:
no change for me :(

@hsgw what is a good series of steps for troubleshooting this?

I'm using windows, but I can also try with linux if needed.

The behaviour is:
- If I plug it in (not pushing any buttons) then it is not recognised (USB device not recognised). Zadig shows it as unknown with no driver. It is also unknown with no driver in device manager.
- If I plug it in while holding boot then release, same behaviour. when I release the boot button, it comes up as not recognised.
- No change if I press any buttons after it is plugged in (like described here https://github.com/hsgw/plaid/blob/master/doc/en/bootloader.md#enter-bootloader-mode or any other combination)

Should I test the soldering with a multimeter? And what should I check?
I bought the kit from mechboards, so the chip should have the bootloader already flashed, but is there a way to test the chip and if the bootloader is working correctly?
What behaviour do I expect from the reset button and boot button?

Thanks!!

hsgw, 2021-07-29:
@jbeanland The following steps may be helpful.
- Verify that components with correct values are mounted in the correct locations
- Use a multimeter to check if the soldering is done correctly
- If you have an Arduino or AVR writer, burn the bootloader again

If these steps completely confirm that it does not work, you know that it does not work due to component failure or error.

> but is there a way to test the chip and if the bootloader is working correctly?
There is no way to confirm this. The easiest way is simply to re-write bootloader.

> What behavior do I expect from the reset button and boot button?
Reset is hardware reset, Boot is entering bootloader mode when the device starts.

rwcts, 2021-07-29:
I did attempt another computer with the same results. In the instructions on how to load a bootloader it should not detect a usb plugged in until clicking and holding down, in a various way the reset and power buttons. It detects the connection to the keyboard (unknown descriptor). Is there a way to start attempting to load the bootloader?

I did check continuity on all connections on the board. all are good too. I get voltage through parts of the board as well. 5v and around 3v (from memory)

hsgw, 2021-07-31:
> starting bootloader
There is no way to get into the bootloader other than by pressing the reset and boot buttons.
However, if there is no firmware written to it, it should automatically enter the bootloader.
This feature sometimes does not work well.

If you are sure that the hardware assembly is perfect and the bootloader has been written, then it might be a fault or error in the MCU, the crystal, or the capacitors around it.

VUSB requires a precise oscillator frequency, and some host computers may not work at all.
Therefore, it is very difficult for me to find out why your keyboard does not work.

jbeanland, 2021-07-31:
Thanks for the information @hsgw, this all helps a lot. I will try some stuff and report back if I find a solution.

benc3d, 2021-08-04:
Just wanted to say, I've also hit this issue.  Originally I sourced my own PCB's and components but after having this issue I then sourced a kit through mechboards and I'm still having the same issue.

A couple of things I did note, none of the LEDs light or blink at all, I'm not sure if they should?

Also the BOOT / RESET buttons appear to be doing nothing.  If I hold both buttons down and plug in the USB, I still get the USB device not recognised prompt in windows and whilst plugged in, the reset button does nothing.  I assumed it should disconnect and reconnect if pressing the button with the USB connected?

@rwcts "One of the assembly instructions I found show the chip to be installed one way but I'm following the board graphics to place the chip in correctly." which component was this?

rwcts, 2021-08-05:
> @rwcts "One of the assembly instructions I found show the chip to be installed one way but I'm following the board graphics to place the chip in correctly." which component was this?

It was the main chip on the board. It was showing the opposite direction in some instructions.

hsgw, 2021-08-06:
> @benc3d Also the BOOT / RESET buttons appear to be doing nothing.

The RESET button is a basic function of the MCU, so it is strange behavior that nothing happens.
If it is not properly recognized by the host computer, it may appear that nothing is happening on the host.

Just to clarify, after you press the RESET/BOOT button, do you release the RESET button first?

benc3d, 2021-08-06:
@hsgw correct, but I have tried all combinations of button presses :)  One thing I should have mentioned and I feel may be important is I have not soldered all my switches and diodes yet as I was wanting to test the MCU / main board before I soldered all my switches, but I've just checked the PCB and noticed the boot button is tied into the COL3 switch, so I will try that and hope I've not been wasting your time!

hsgw, 2021-08-07:
> @benc3d the boot button is tied into the COL3 switch

This is correct. BOOT and col3 share MCU pins.
And you can test without soldering diodes and switches.

benc3d, 2021-08-20:
@rwcts @jbeanland So after a bunch of debugging my issue turned out to be that my MCU that I purchased as part of the kit was not flashed with a bootloader (the description said it was).  I ended up following this guide to get the bootloader flashed https://www.algorist.co.uk/post/how-to-burn-the-plaid-keyboard-bootloader-using-arduino-nano/
(but I did it all on a bread board as I still wasn't sure if the issues was the MCU or a failed component) but after flashing the hex from that page, it all seems to be working!  I just need to finish soldering my switches now!

Thread 36 (2021-11-23):

Keyboard lag

richard-davey-arcadisgen, 2021-11-23:
I'm typing this up on a plaid and it's pretty hard going. There's lag in polling key presses, mostly after a period of not typing anything.

I've burned the bootloader myself using the standard fuse bit settings. It burns successfully and keymaps can be subsequently uploaded.

hsgw, 2021-11-30:
Hi, I have never had such a problem in my environment.
Since the USB device is emulated by software, it may be a limitation of the MCU's performance or something.
I'm sorry this isn't helping, just information.

richard-davey-arcadisgen, 2021-12-01:
My MCU is an ATMEL ATMEGA 328P U, which I'm assuming is what everyone else uses for this keyboard? The odd thing is that it is as if it takes a while to wake itself after a key press when left unattended for a while (around 30 seconds). This makes me think it is either a fuse bit setting or a firmware setting. I'm using a fairly up to date version of QMK (around June 2021).

richard-davey-arcadisgen, 2021-12-06:
Never mind. The keyboard is working now using the standard fuse bits and v-usb standard firmware and I'm pretty sure it must have been an external problem. Probably a loose cable, or extreme low temperatures or something.

Closed 2021-12-06.

Thread 37 (2021-12-09):

[platforms/avr/flash.mk:181: flash] Segmentation fault

Shredcrab, 2021-12-09:
Hello,

I bought a Plaid kit from keycapsss.com. As far as I understand the bootloader is already flashed. I have the latest libusbk drivers installed for the device.
I can compile a Keyboard Layout in QMK however when I try to compile and flash the default layout, as in the documentation, i get the following  exception:

`QMK Firmware 0.15.5
Making dm9records/plaid with keymap default and target flash

avr-gcc.exe (GCC) 8.4.0
Copyright (C) 2018 Free Software Foundation, Inc.
This is free software; see the source for copying conditions.  There is NO
warranty; not even for MERCHANTABILITY or FITNESS FOR A PARTICULAR PURPOSE.

Size before:
   text    data     bss     dec     hex filename
      0   16822       0   16822    41b6 .build/dm9records_plaid_default.hex

Copying dm9records_plaid_default.hex to qmk_firmware folder                                         [OK]
Checking file size of dm9records_plaid_default.hex                                                  [OK]
 * The firmware size is fine - 16822/28672 (58%, 11850 bytes free)
make[1]: *** [platforms/avr/flash.mk:181: flash] Segmentation fault
Make finished with errors
make: *** [Makefile:478: dm9records/plaid:default:flash] Fehler 1`

It seems that the default Keyboard Layout and firmware was already on the chip because when I thest the board (by connecting the switch pads with a wire) it works

Shredcrab, 2021-12-09:
Chip was already flashed with VIA.
I hope I didn't waste anybodys time and sorry for being stupid.

Closed 2021-12-09.

Thread 38 (2022-03-03):

Switch plate compatibility (for hotswap)

YassineGherbi, 2022-03-03:
I know the Plaid Kit is shipped without a switch plate but I would like to know if there's any compatible plate (maybe with some modding).

I've added Mill-Max sockets to made it hot-swappable but then discovered that this doesn't work all that well when you don't have a plate. I'm still pretty new to this hobby so If there's another way to make hot-swap work without a plate I would also appreciate it to be informed about those options. Thanks a lot!

hsgw, 2022-03-13:
I have seen someone making plate.
https://twitter.com/lekipon/status/1337675289464225794

YassineGherbi, 2022-03-20:
Any idea where it’s being sold? I’ve looked everywhere but can’t find anything.

thorstenweber83, 2022-04-20:
Looks like the USB-C fork of this repo also contains gerber files for a plate:
 https://github.com/piit79/plaid-c/blob/main/pcb/gerber/plaid-c-plate-1.2.42D.zip

You can use this file to order from jlcpcb.com or similar companies.

Thread 39 (2023-05-29):

Gerber files for main pcb, switch plate, bottom plate

syenasweta, 2023-05-29:
Where can I find it?

syenasweta, 2023-05-29:
Hi @hsgw and all developer of Plaid,

My capability is not in electronics. I just want to print and use your pcb for independent-use according to your original concept, namely through-hole with vusb.

So, would you mind making a gerber file (main pcb, switch plate pcb, and bottom pcb), so that ordinary people can use your ready-to-print master gerber file?

hsgw, 2023-06-04:
Different factories producing PCBs may require different Gerber data. I cannot guarantee that, so I do not distribute that directly.

And there are many helpful instruciton available, so download kicad and try it for yourself.

Closed 2023-06-04.
