hsgw/plaid/pcb/plaid.pdf

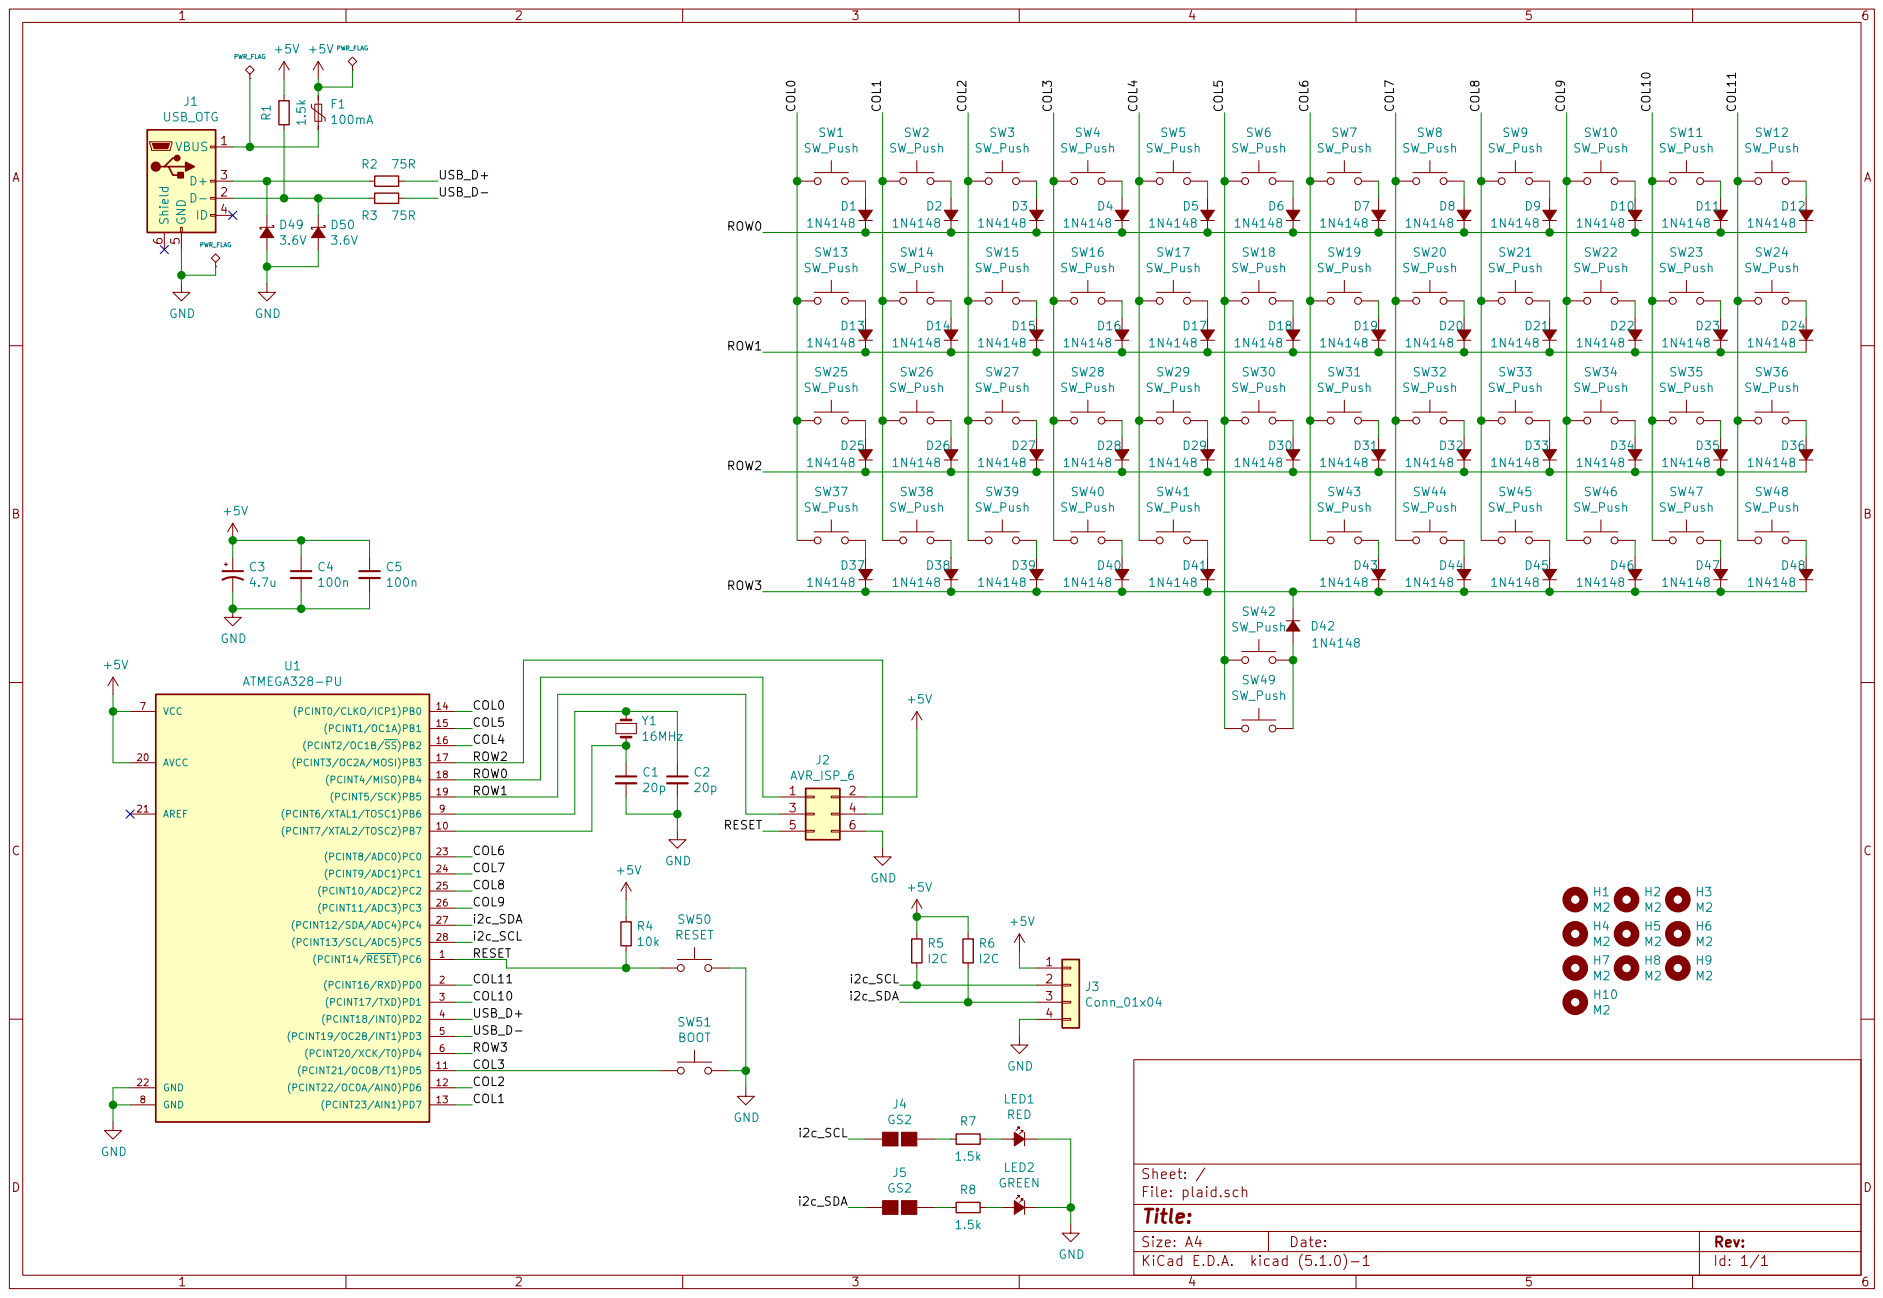
[picture p39: page 1]

File: plaid.sch Sheet: /
Id: 1/1 Title:
