hsgw/plaid/pcb/plaid.kicad_pcb

## KiCad design pcb/plaid.kicad_pcb (2019-04-07)

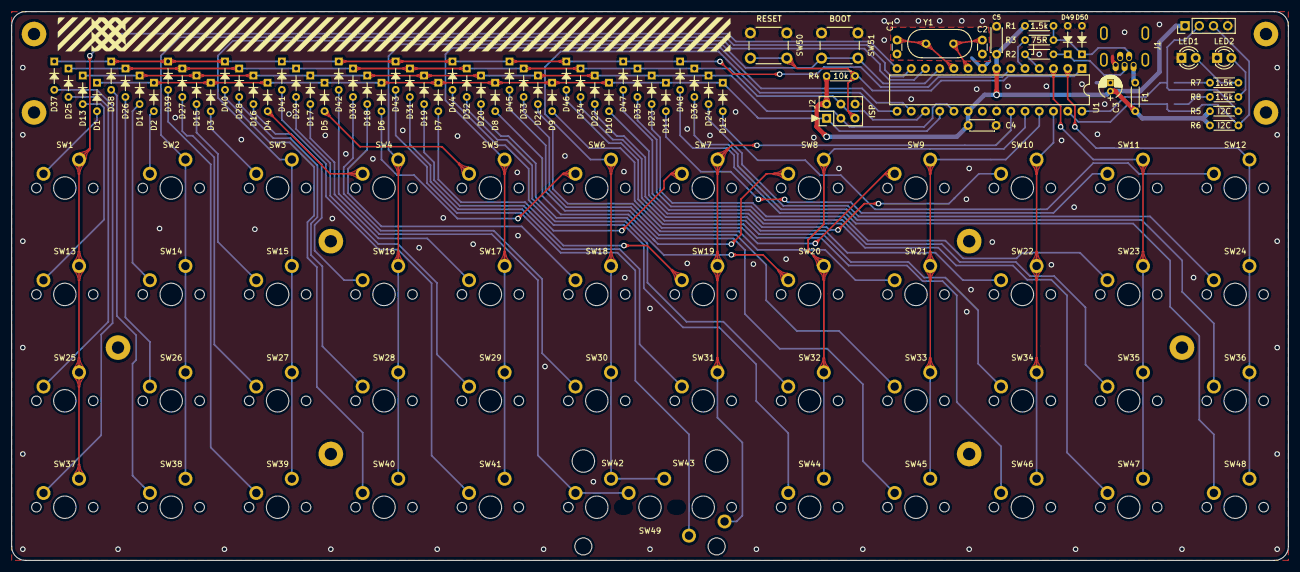
[picture p40: board plaid.kicad_pcb from above]

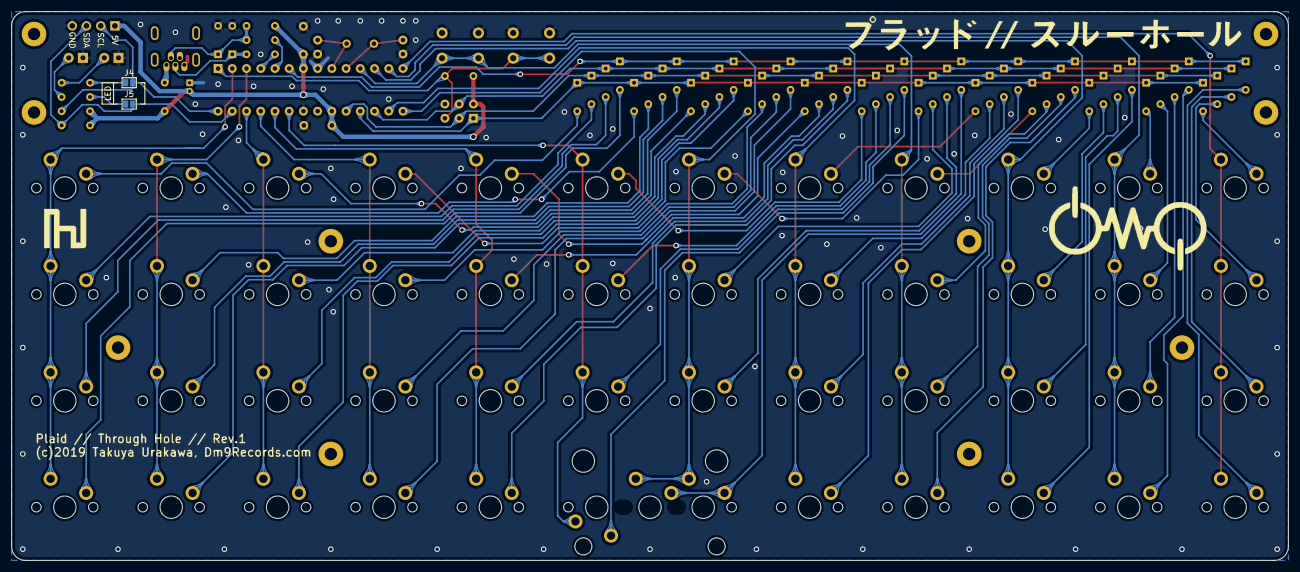
[picture p41: board plaid.kicad_pcb from below]

Board: 2 copper layers, 228.0 x 98.0 mm, 134 parts (2 on the bottom side), 80 nets.

Parts:
C1, C2: 20p; C_Disc_D3.0mm_W1.6mm_P2.50mm
C3: 10u; CP_Radial_D4.0mm_P1.50mm
C4, C5: 100n; C_Disc_D4.3mm_W1.9mm_P5.00mm
D1, D2, D3, D4, D5, D6, D7, D8, D9, D10, D11, D12, D13, D14, D15, D16, D17, D18, D19, D20, D21, D22, D23, D24, D25, D26, D27, D28, D29, D30, D31, D32, D33, D34, D35, D36, D37, D38, D39, D40, D41, D42, D43, D44, D45, D46, D47, D48: 1N4148; D_DO-35_SOD27_P5.08mm_Horizontal
D49, D50: 3.6V; D_DO-35_SOD27_P5.08mm_Horizontal
F1: 100mA; polyfuse_5.1mm
H1, H2, H3, H4, H5, H6, H7, H8, H9, H10: M2; MountingHole_2.2mm_M2_Pad
J1: USB_OTG; USB_MINIB_Akizuki_MUSB-5BF01AS
J2: AVR_ISP_6; Pin_Header_Straight_2x03_Pitch2.54mm
J3: Conn_01x04; Pin_Header_Straight_1x04_Pitch2.54mm
J4, J5: GS2
LED1: RED; LED_D3.0mm
LED2: GREEN; LED_D3.0mm
R1, R7, R8: 1.5k; R_Axial_DIN0204_L3.6mm_D1.6mm_P5.08mm_Horizontal
R2, R3: 75R; R_Axial_DIN0204_L3.6mm_D1.6mm_P5.08mm_Horizontal
R4: 10k; R_Axial_DIN0204_L3.6mm_D1.6mm_P5.08mm_Horizontal
R5, R6: I2C; R_Axial_DIN0204_L3.6mm_D1.6mm_P5.08mm_Horizontal
SW1, SW2, SW3, SW4, SW5, SW6, SW7, SW8, SW9, SW10, SW11, SW12, SW13, SW14, SW15, SW16, SW17, SW18, SW19, SW20, SW21, SW22, SW23, SW24, SW25, SW26, SW27, SW28, SW29, SW30, SW31, SW32, SW33, SW34, SW35, SW36, SW37, SW38, SW39, SW40, SW41, SW42, SW43, SW44, SW45, SW46, SW47, SW48: SW_Push; SW_Cherry_MX1A_1.00u_PCB
SW49: SW_Push; SW_Cherry_MX1A_2.0U_PCB_universal_center
SW50: RESET; SW_PUSH_6mm
SW51: BOOT; SW_PUSH_6mm
U1: ATMEGA328-PU; DIP-28_W7.62mm
Y1: 16MHz; Crystal_HC49-4H_Vertical

Connections:
+5V: C3.1, C4.1, C5.1, F1.2, J2.2, J3.1, R1.2, R4.1, R5.1, R6.1, U1.7, U1.20
/COL0: SW1.2, SW13.2, SW25.2, SW37.2, U1.14
/COL1: SW2.2, SW14.2, SW26.2, SW38.2, U1.13
/COL2: SW3.2, SW15.2, SW27.2, SW39.2, U1.12
/COL3: SW4.2, SW16.2, SW28.2, SW40.2, SW51.1, U1.11
/COL4: SW5.2, SW17.2, SW29.2, SW41.2, U1.16
/COL5: SW6.2, SW18.2, SW30.2, SW42.2, SW49.2, U1.15
/COL6: SW7.2, SW19.2, SW31.2, SW43.1, U1.23
/COL7: SW8.2, SW20.2, SW32.2, SW44.2, U1.24
/COL8: SW9.2, SW21.2, SW33.2, SW45.2, U1.25
/COL9: SW10.2, SW22.2, SW34.2, SW46.2, U1.26
/COL10: SW11.2, SW23.2, SW35.2, SW47.2, U1.3
/COL11: SW12.2, SW24.2, SW36.2, SW48.2, U1.2
/RESET: J2.5, R4.2, SW50.1, U1.1
/ROW0: D1.1, D2.1, D3.1, D4.1, D5.1, D6.1, D7.1, D8.1, D9.1, D10.1, D11.1, D12.1, J2.1, U1.18
/ROW1: D13.1, D14.1, D15.1, D16.1, D17.1, D18.1, D19.1, D20.1, D21.1, D22.1, D23.1, D24.1, J2.3, U1.19
/ROW2: D25.1, D26.1, D27.1, D28.1, D29.1, D30.1, D31.1, D32.1, D33.1, D34.1, D35.1, D36.1, J2.4, U1.17
/ROW3: D37.1, D38.1, D39.1, D40.1, D41.1, D42.1, D43.1, D44.1, D45.1, D46.1, D47.1, D48.1, U1.6
/USB_D+: R2.1, U1.4
/USB_D-: R3.1, U1.5
/i2c_SCL: J3.2, J4.2, R5.2, U1.28
/i2c_SDA: J3.3, J5.2, R6.2, U1.27
GND: C1.2, C2.2, C3.2, C4.2, C5.2, D49.2, D50.2, J1.5, J2.6, J3.4, LED1.1, LED2.1, SW50.2, SW51.2, U1.8, U1.22
unnamed: C1.1, U1.10, Y1.2
unnamed: C2.1, U1.9, Y1.1
unnamed: D1.2, SW1.1
unnamed: D2.2, SW2.1
unnamed: D3.2, SW3.1
unnamed: D4.2, SW4.1
unnamed: D5.2, SW5.1
unnamed: D6.2, SW6.1
unnamed: D7.2, SW7.1
unnamed: D8.2, SW8.1
unnamed: D9.2, SW9.1
unnamed: D10.2, SW10.1
unnamed: D11.2, SW11.1
unnamed: D12.2, SW12.1
unnamed: D13.2, SW13.1
unnamed: D14.2, SW14.1
unnamed: D15.2, SW15.1
unnamed: D16.2, SW16.1
unnamed: D17.2, SW17.1
unnamed: D18.2, SW18.1
unnamed: D19.2, SW19.1
unnamed: D20.2, SW20.1
unnamed: D21.2, SW21.1
unnamed: D22.2, SW22.1
unnamed: D23.2, SW23.1
unnamed: D24.2, SW24.1
unnamed: D25.2, SW25.1
unnamed: D26.2, SW26.1
unnamed: D27.2, SW27.1
unnamed: D28.2, SW28.1
unnamed: D29.2, SW29.1
unnamed: D30.2, SW30.1
unnamed: D31.2, SW31.1
unnamed: D32.2, SW32.1
unnamed: D33.2, SW33.1
unnamed: D34.2, SW34.1
unnamed: D35.2, SW35.1
unnamed: D36.2, SW36.1
unnamed: D37.2, SW37.1
unnamed: D38.2, SW38.1
unnamed: D39.2, SW39.1
unnamed: D40.2, SW40.1
unnamed: D41.2, SW41.1
unnamed: D42.2, SW42.1, SW49.1
unnamed: D43.2, SW43.2
unnamed: D44.2, SW44.1
unnamed: D45.2, SW45.1
unnamed: D46.2, SW46.1
unnamed: D47.2, SW47.1
unnamed: D48.2, SW48.1
unnamed: D49.1, J1.3, R2.2
unnamed: D50.1, J1.2, R1.1, R3.2
unnamed: F1.1, J1.1
unnamed: J4.1, R7.1
unnamed: J5.1, R8.1
unnamed: LED1.2, R7.2
unnamed: LED2.2, R8.2
