hsgw/plaid/(commit log)

2018-12-12 update pcb add readme.md
    [plaid.kicad_pcb]
2018-12-12 add schematic pdf
2018-12-21 add rev.alpha buildguide fix schematic
    [plaid.sch]
2019-02-14 Add BOM. doesn't include switches.
    BOM has been generated through digi-key.
    [Bill Of Materials.csv]
2019-02-17 Revert "Add BOM. doesn't include switches."
    [Bill Of Materials.csv]
2019-02-17 Add recommend usb connector to buildguide
2019-04-07 Plaid Rev.1 Release
    [cover.dwg, plaid.kicad_pcb, plaid.sch, plaid_BOM.csv, plaid_bottom.kicad_pcb, plaid_plate.kicad_pcb]
2019-04-07 Complete soldering.md
2019-04-15 Fix image of screw
