hsgw/plaid/(notices)

Notices in the files:
pcb/plaid.kicad_pcb:
(c)2019 Takuya Urakawa, Dm9Records.com
